hasithvm/Proxima/board/cc3200board/notes.md

Description
-----------

This document contains information about deviations from the CC3200 reference design.

Changes
-------------

1. Part Swap: Q24FA20H00396 => ABM3B-40.000MHZ-10-1-U-T

Requires changing capacitor values C42, C49 to 10pF.

http://www.adafruit.com/blog/2012/01/24/choosing-the-right-crystal-and-caps-for-your-design/
http://ww1.microchip.com/downloads/en/AppNotes/00826a.pdf
