hasithvm/Proxima/board/cc3200modboard/cc3200modboard.pdf

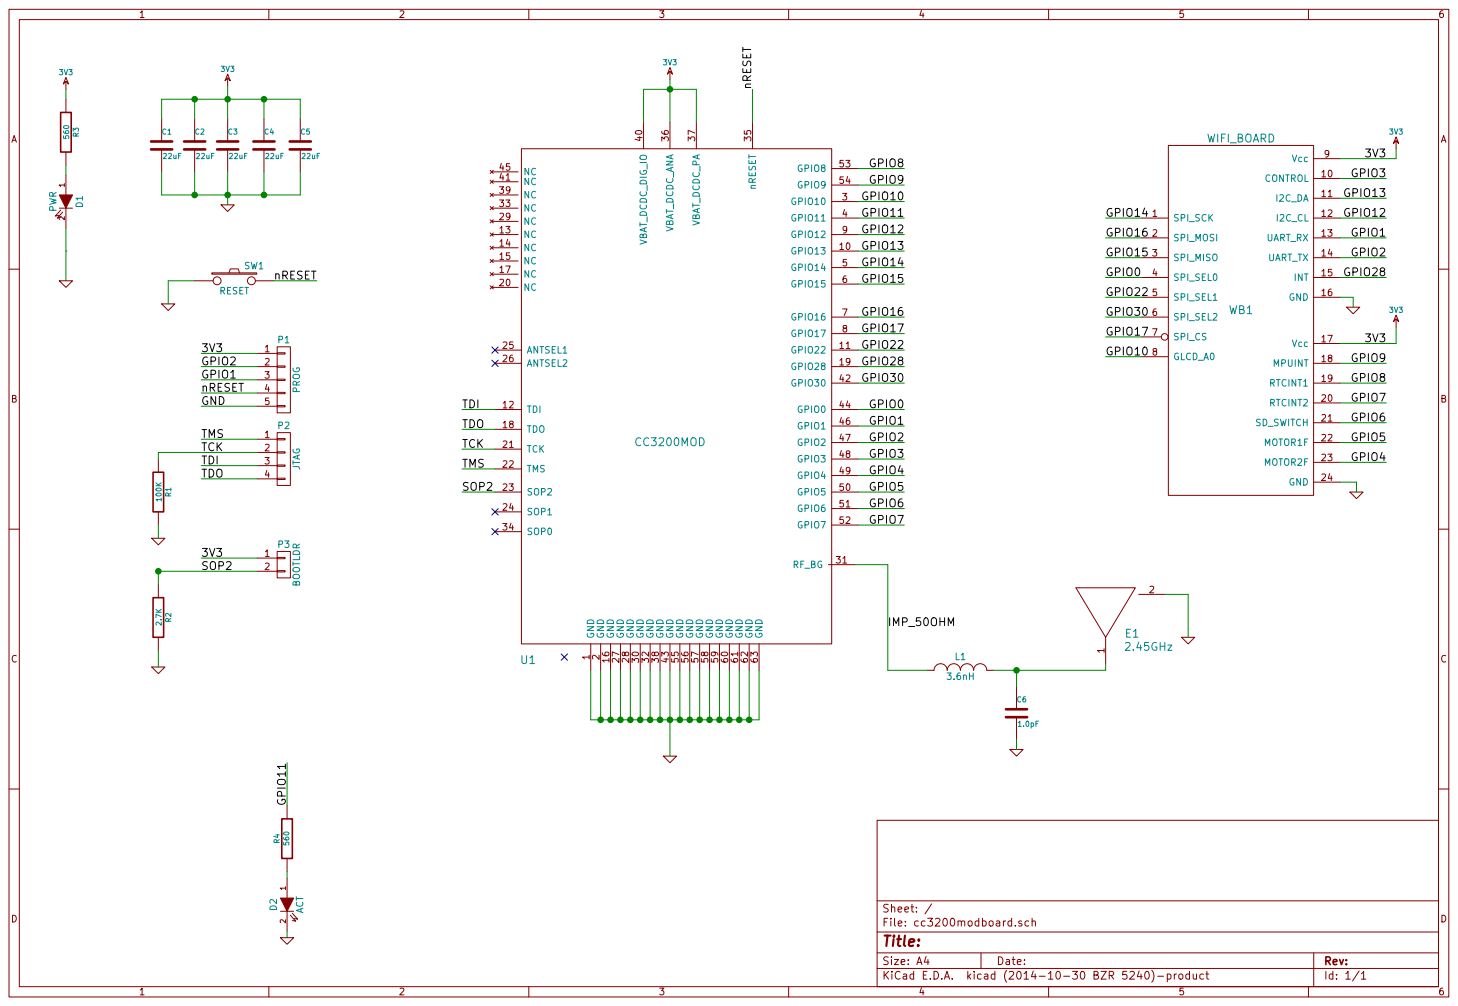
[picture p3: page 1]

2 GPIO10 3 GPIO11 4 GPIO14 5 GPIO15 6 GPIO16 7 GPIO17 8 GPIO12 9 GPIO13 10 NC 20 GND 30 VBAT_DCDC_DIG_IO 40 GPIO5 50 GND 60 GPIO22 11 TCK 21 RF_BG 31 NC 41 GPIO6 51 GND 61 TDI 12 TMS 22 GND 32 GPIO30 42 GPIO7 52 GND 62 NC 13 SOP2 23 NC 33 GND 43 GPIO8 53 GND 63 NC 14 SOP1 24 SOP0 34 GPIO0 44 GPIO9 54 NC 15 ANTSEL1 25 nRESET 35 NC 45 GND 55 GND 16 ANTSEL2 26 VBAT_DCDC_ANA 36 GPIO1 46 GND 56 NC 17 GND 27 VBAT_DCDC_PA 37 GPIO2 47 GND 57 TDO 18 GND 28 GND 38 GPIO3 48 GND 58 GPIO28 19 NC 29 NC 39 GPIO4 49 GND U1 59

TCK | 2

Id: 1/1 Title: File: cc3200modboard.sch Sheet: / GND
