hasithvm/Proxima/board/cc3200modboard/cc3200modboard.kicad_pcb

## KiCad design board/cc3200modboard/cc3200modboard.kicad_pcb (2015-07-12)

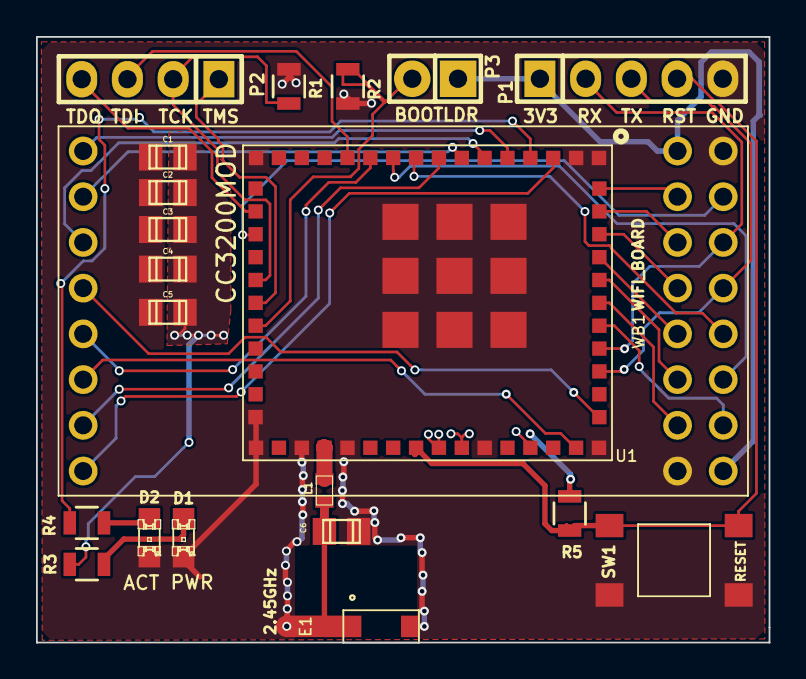
[picture p4: board cc3200modboard.kicad_pcb from above]

Board: 2 copper layers, 40.7 x 33.6 mm, 21 parts (0 on the bottom side), 33 nets.

Parts:
C1, C2, C3, C4, C5: 22uF; c_0805
C6: 1.0pF; c_0805
D1: PWR; LED-0805
D2: ACT; LED-0805
E1: 2.45GHz; 2.4GHz_ANT_AH316M245001-T
L1: 3.6nH; IND_RF_0603
P1: PROG; Pin_Header_Straight_1x05
P2: JTAG; Pin_Header_Straight_1x04
P3: BOOTLDR; Pin_Header_Straight_1x02
R1: 100K; R_0805
R2: 2.7K; R_0805
R3, R4: 560; R_0805
R5: 10K; R_0805
SW1: RESET; PTS645
U1: CC3200MOD
WB1: WIFI_BOARD; DaughterBoard

Connections:
3V3: C1.1, C2.1, C3.1, C4.1, C5.1, P1.1, P3.1, R3.1, R5.1, U1.36, U1.37, U1.40, WB1.9, WB1.17
/GPIO0: U1.44, WB1.4
/GPIO1: P1.3, U1.46, WB1.13
/GPIO2: P1.2, U1.47, WB1.14
/GPIO3: U1.48, WB1.10
/GPIO4: U1.49, WB1.23
/GPIO5: U1.50, WB1.22
/GPIO6: U1.51, WB1.21
/GPIO7: U1.52, WB1.20
/GPIO8: U1.53, WB1.19
/GPIO9: U1.54, WB1.18
/GPIO10: U1.3, WB1.8
/GPIO11: R4.1, U1.4
/GPIO12: U1.9, WB1.12
/GPIO13: U1.10, WB1.11
/GPIO14: U1.5, WB1.1
/GPIO15: U1.6, WB1.3
/GPIO16: U1.7, WB1.2
/GPIO17: U1.8, WB1.7
/GPIO22: U1.11, WB1.5
/GPIO28: U1.19, WB1.15
/GPIO30: U1.42, WB1.6
/IMP_50OHM: L1.1, U1.31
/RF_FEED: C6.1, E1.1, L1.2
/SOP2: P3.2, R2.1, U1.23
/TCK: P2.2, R1.1, U1.21
/TDI: P2.3, U1.12
/TDO: P2.4, U1.18
/TMS: P2.1, U1.22
/nRESET: P1.4, R5.2, SW1.2, U1.35
GND: C1.2, C2.2, C3.2, C4.2, C5.2, C6.2, D1.2, D2.2, E1.2, P1.5, R1.2, R2.2, SW1.1, U1.1, U1.2, U1.16, U1.27, U1.28, U1.30, U1.32, U1.38, U1.43, U1.55, U1.56, U1.57, U1.58, U1.59, U1.60, U1.61, U1.62, U1.63, WB1.16, WB1.24
unnamed: D1.1, R3.2
unnamed: D2.1, R4.2
