hasithvm/Proxima/board/cc3200board/cc3200board.kicad_pcb

## KiCad design board/cc3200board/cc3200board.kicad_pcb (2015-03-09)

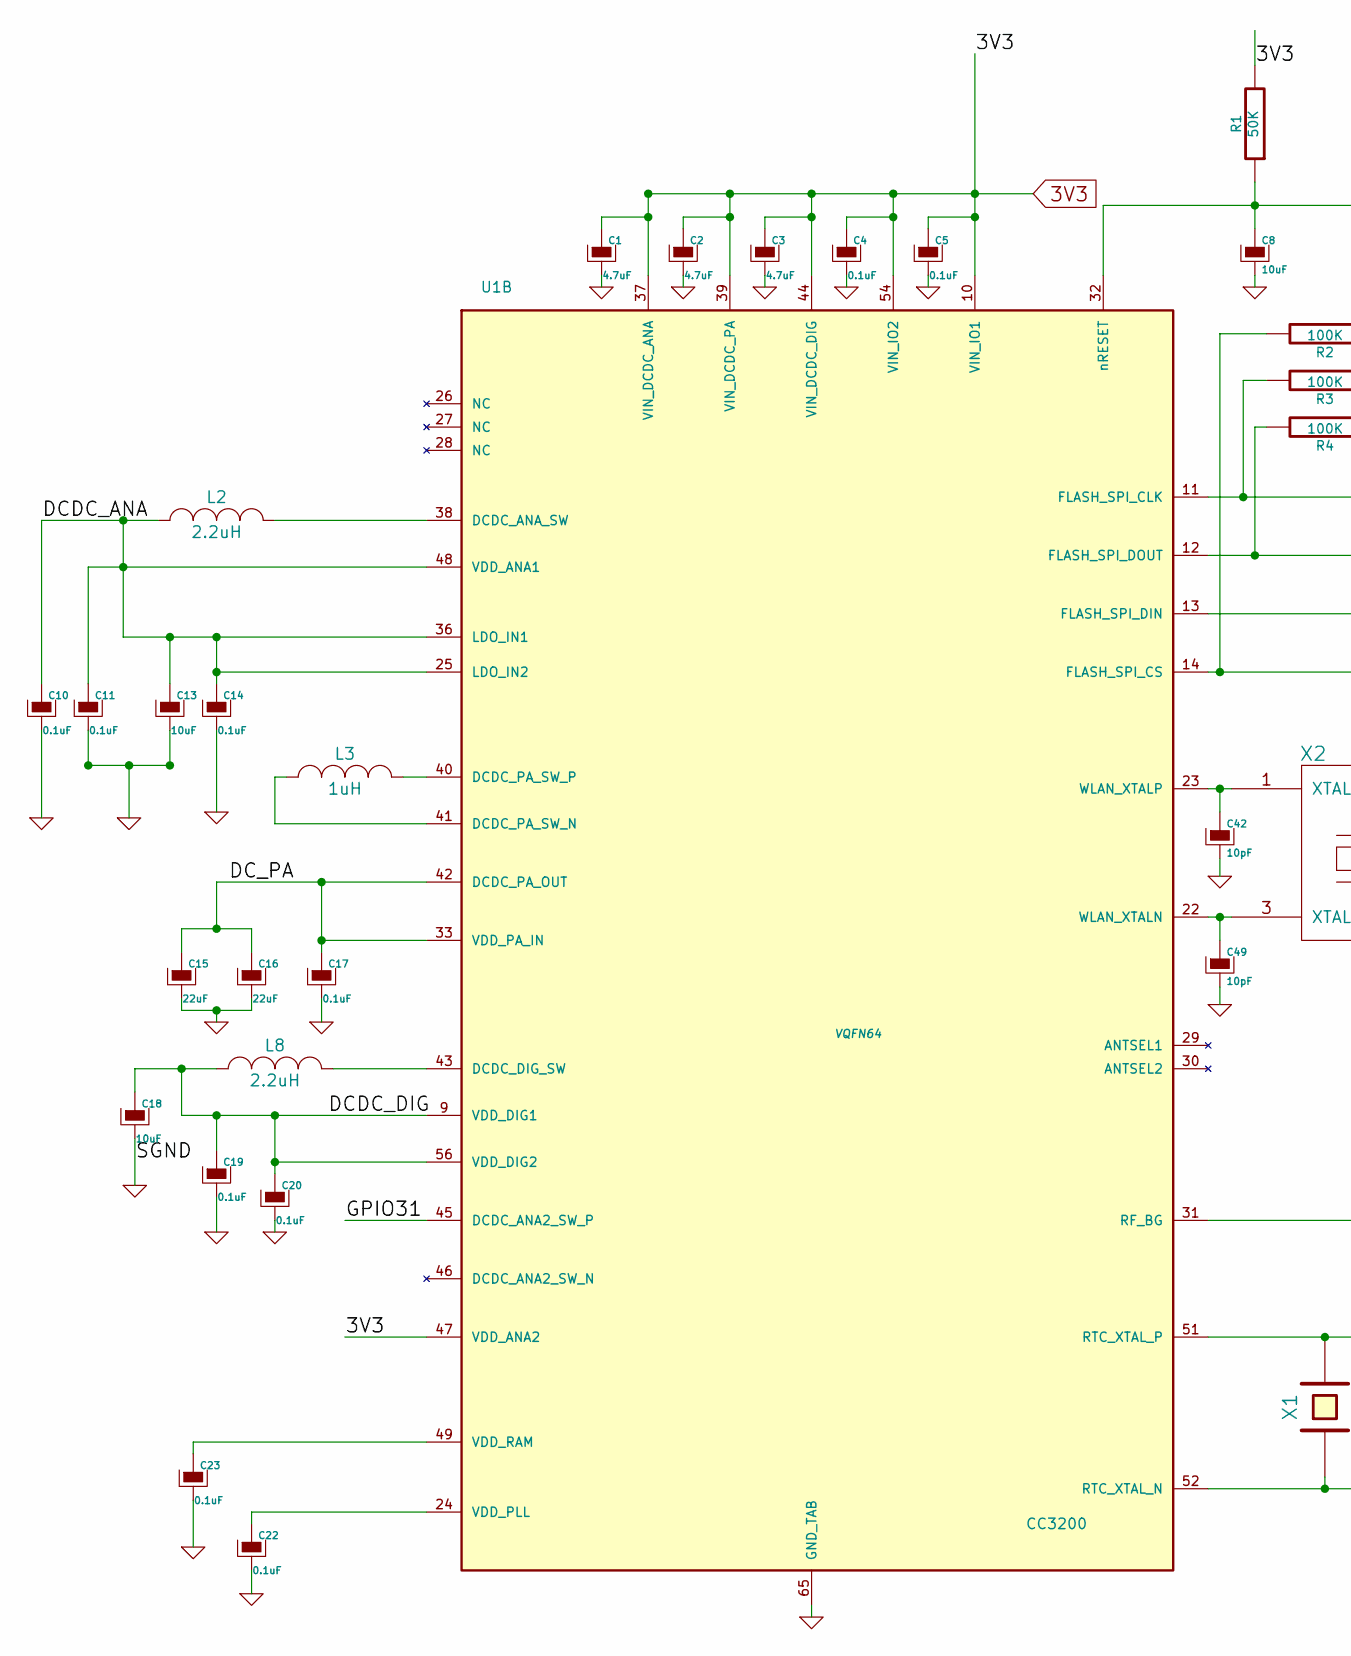
[picture p5: schematic cc3200board.sch, part in row 1, column 1]

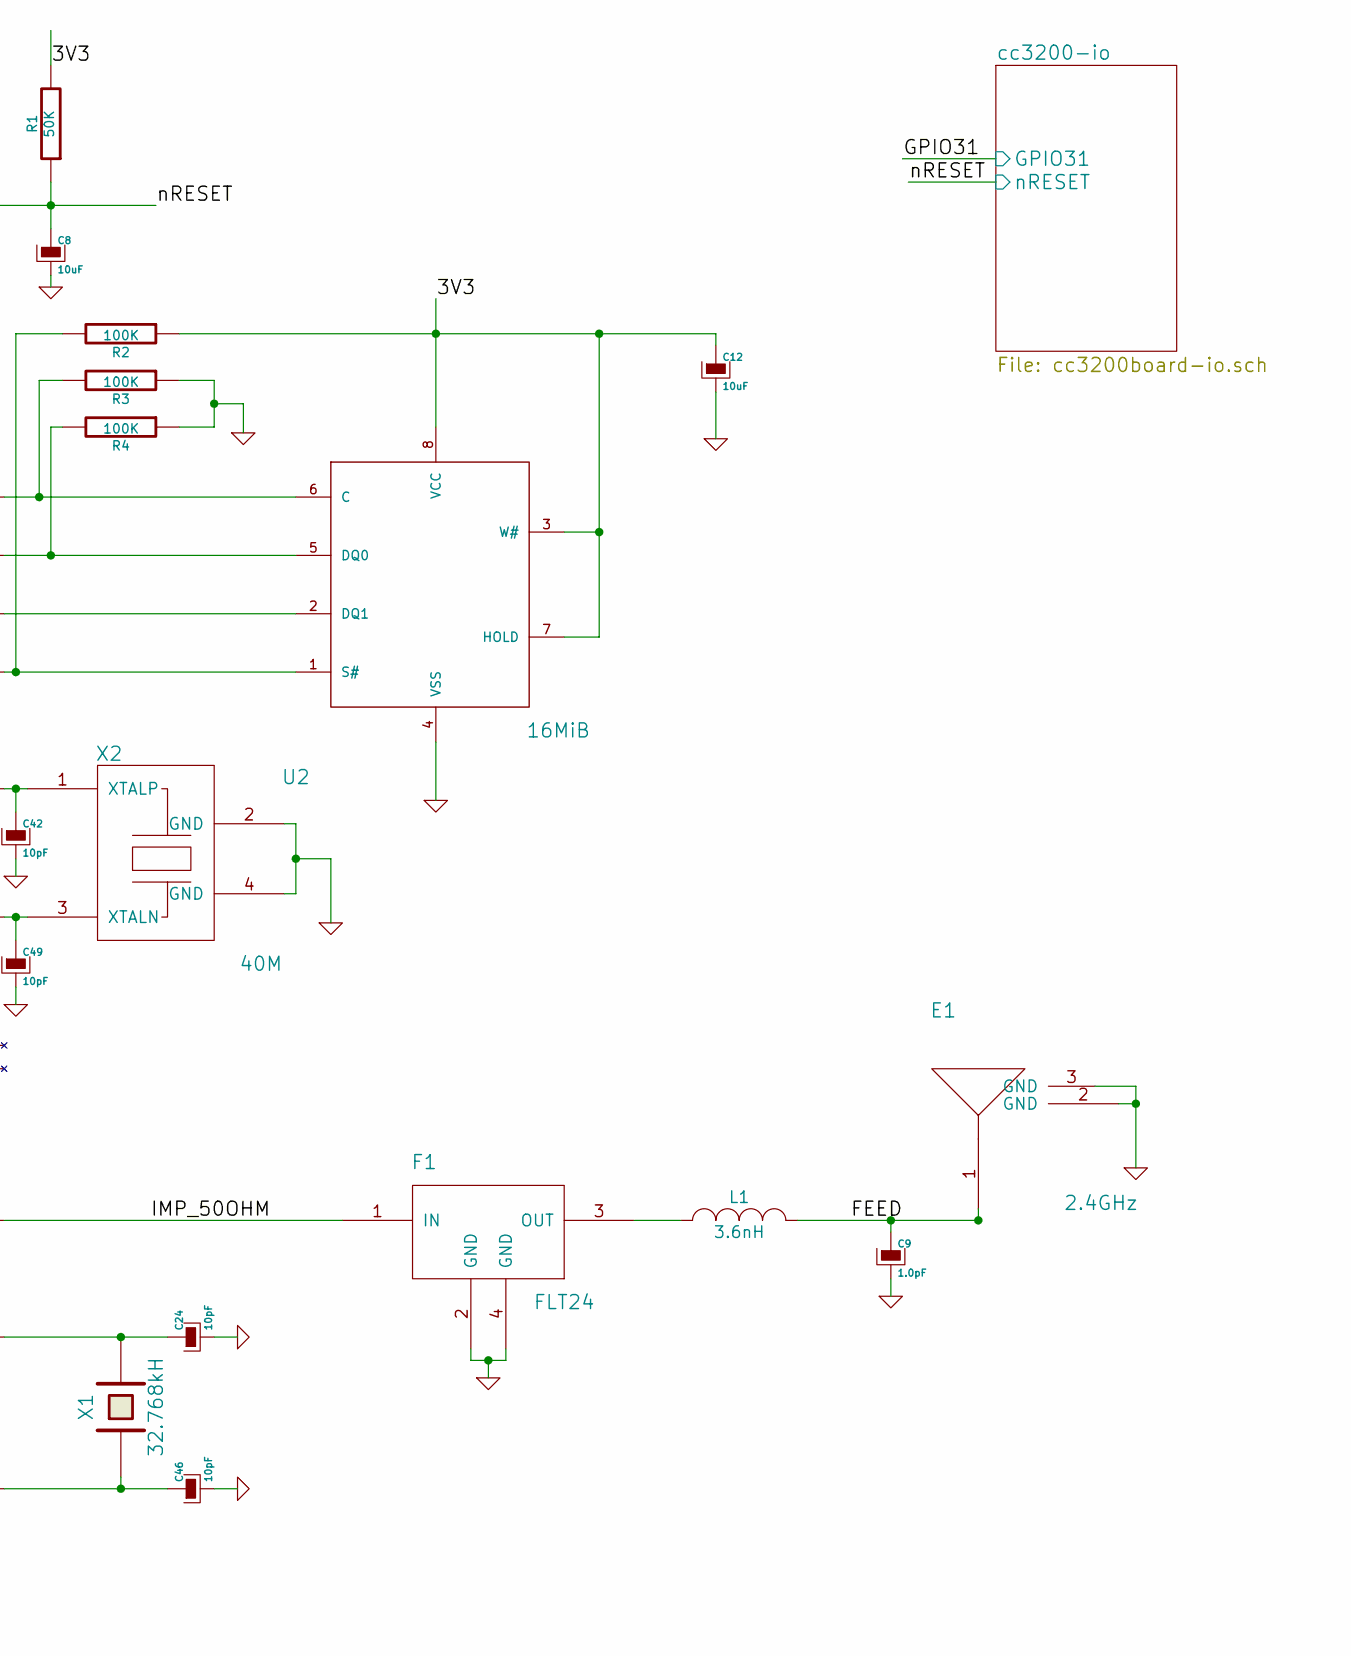
[picture p6: schematic cc3200board.sch, part in row 1, column 2]

Parts:
C1, C2, C3: 4.7uF
C4, C5, C10, C11, C14, C17, C19, C20, C22, C23: 0.1uF
C8, C12, C13, C18: 10uF
C9: 1.0pF
C15, C16: 22uF
C24, C42, C46, C49: 10pF
E1: 2.4GHz; PartNum AH316M245001-T
F1: FLT24
L1: 3.6nH
L2, L8: 2.2uH
L3: 1uH
R1: 50K
R2, R3, R4: 100K
U1: CC3200; VQFN64; PartNum CC3200R1M2RGCR
U2: 16MiB; PartNum N25Q128A13ESE40E
X1: 32.768kH
X2: 40M; PartNumber ABM3B-40.000MHZ-10-1-U-T

Connections:
3V3: C1.1, C2.1, C3.1, C4.1, C5.1, C12.1, R1.2, R2.1, U1.10 (VIN_IO1), U1.37 (VIN_DCDC_ANA), U1.39 (VIN_DCDC_PA), U1.44 (VIN_DCDC_DIG), U1.47 (VDD_ANA2), U1.54 (VIN_IO2), U2.3 (W#), U2.7 (HOLD), U2.8 (VCC); also elsewhere on the board
/DCDC_ANA: C10.1, C11.1, C13.1, C14.1, L2.1, U1.25 (LDO_IN2), U1.36 (LDO_IN1), U1.48 (VDD_ANA1)
/DCDC_DIG: C18.1, C19.1, C20.1, L8.1, U1.9 (VDD_DIG1), U1.56 (VDD_DIG2)
/DC_PA: C15.1, C16.1, C17.1, U1.33 (VDD_PA_IN), U1.42 (DCDC_PA_OUT)
/FEED: C9.1, E1.1, L1.2
/IMP_50OHM: F1.1 (IN), U1.31 (RF_BG)
/cc3200-io/GPIO31: U1.45 (DCDC_ANA2_SW_P); also elsewhere on the board
/cc3200-io/nRESET: C8.1, R1.1, U1.32 (nRESET); also elsewhere on the board
GND: C1.2, C2.2, C3.2, C4.2, C5.2, C8.2, C9.2, C10.2, C11.2, C12.2, C13.2, C14.2, C15.2, C16.2, C17.2, C18.2, C19.2, C20.2, C22.2, C23.2, C24.2, C42.2, C46.2, C49.2, E1.2 (GND), E1.3 (GND), F1.2 (GND), F1.4 (GND), R3.1, R4.1, U1.65 (GND_TAB), U2.4 (VSS), X2.2 (GND), X2.4 (GND); also elsewhere on the board
unnamed: C22.1, U1.24 (VDD_PLL)
unnamed: C23.1, U1.49 (VDD_RAM)
unnamed: C24.1, U1.51 (RTC_XTAL_P), X1.2
unnamed: C42.1, U1.23 (WLAN_XTALP), X2.1 (XTALP)
unnamed: C46.1, U1.52 (RTC_XTAL_N), X1.1
unnamed: C49.1, U1.22 (WLAN_XTALN), X2.3 (XTALN)
unnamed: F1.3 (OUT), L1.1
unnamed: L2.2, U1.38 (DCDC_ANA_SW)
unnamed: L3.1, U1.41 (DCDC_PA_SW_N)
unnamed: L3.2, U1.40 (DCDC_PA_SW_P)
unnamed: L8.2, U1.43 (DCDC_DIG_SW)
unnamed: R2.2, U1.14 (FLASH_SPI_CS), U2.1 (S#)
unnamed: R3.2, U1.11 (FLASH_SPI_CLK), U2.6 (C)
unnamed: R4.2, U1.12 (FLASH_SPI_DOUT), U2.5 (DQ0)
unnamed: U1.13 (FLASH_SPI_DIN), U2.2 (DQ1)

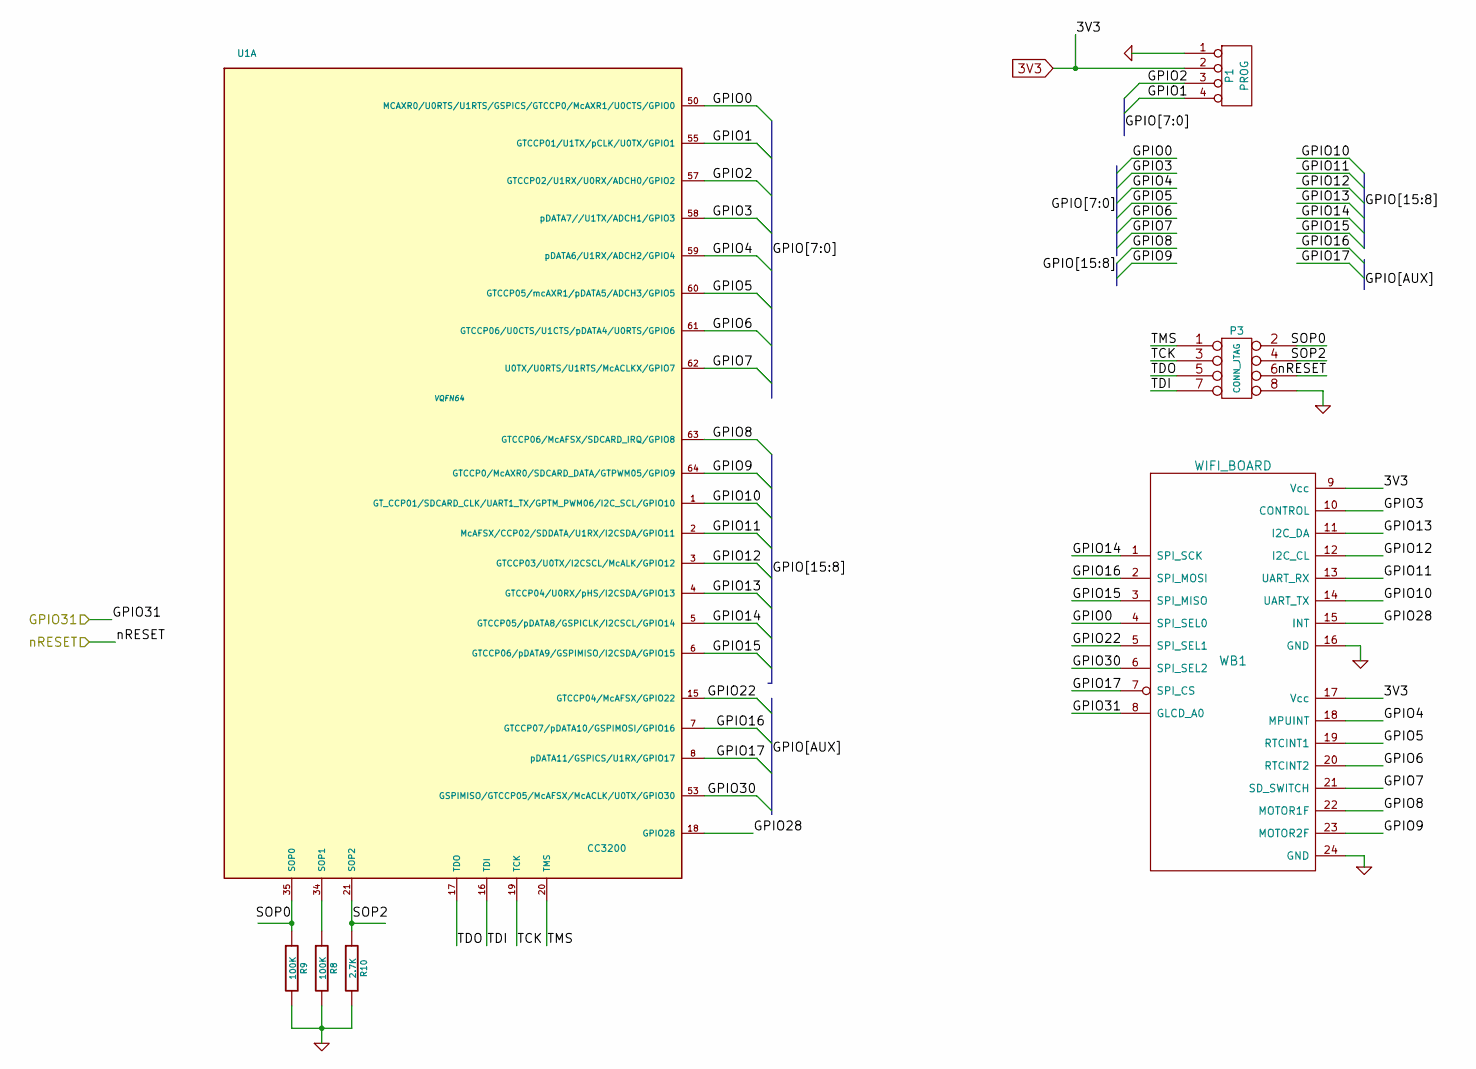
[picture p7: schematic cc3200board-io.sch]

Parts:
P1: PROG
P3: CONN_JTAG
R8, R9: 100K
R10: 2.7K
U1: CC3200; VQFN64
WB1: WIFI_BOARD

Connections:
3V3: P1.2, WB1.9 (Vcc), WB1.17 (Vcc); also elsewhere on the board
/cc3200-io/GPIO0: U1.50 (MCAXR0/U0RTS/U1RTS/GSPICS/GTCCP0/McAXR1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), WB1.4 (SPI_SEL0)
/cc3200-io/GPIO1: P1.4, U1.55 (GTCCP01/U1TX/pCLK/U0TX/GPIO1)
/cc3200-io/GPIO2: P1.3, U1.57 (GTCCP02/U1RX/U0RX/ADCH0/GPIO2)
/cc3200-io/GPIO3: U1.58 (pDATA7//U1TX/ADCH1/GPIO3), WB1.10 (CONTROL)
/cc3200-io/GPIO4: U1.59 (pDATA6/U1RX/ADCH2/GPIO4), WB1.18 (MPUINT)
/cc3200-io/GPIO5: U1.60 (GTCCP05/mcAXR1/pDATA5/ADCH3/GPIO5), WB1.19 (RTCINT1)
/cc3200-io/GPIO6: U1.61 (GTCCP06/U0CTS/U1CTS/pDATA4/U0RTS/GPIO6), WB1.20 (RTCINT2)
/cc3200-io/GPIO7: U1.62 (U0TX/U0RTS/U1RTS/McACLKX/GPIO7), WB1.21 (SD_SWITCH)
/cc3200-io/GPIO8: U1.63 (GTCCP06/McAFSX/SDCARD_IRQ/GPIO8), WB1.22 (MOTOR1F)
/cc3200-io/GPIO9: U1.64 (GTCCP0/McAXR0/SDCARD_DATA/GTPWM05/GPIO9), WB1.23 (MOTOR2F)
/cc3200-io/GPIO10: U1.1 (GT_CCP01/SDCARD_CLK/UART1_TX/GPTM_PWM06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), WB1.14 (UART_TX)
/cc3200-io/GPIO11: U1.2 (McAFSX/CCP02/SDDATA/U1RX/I2CSDA/GPIO11), WB1.13 (UART_RX)
/cc3200-io/GPIO12: U1.3 (GTCCP03/U0TX/I2CSCL/McALK/GPIO12), WB1.12 (I2C_CL)
/cc3200-io/GPIO13: U1.4 (GTCCP04/U0RX/pHS/I2CSDA/GPIO13), WB1.11 (I2C_DA)
/cc3200-io/GPIO14: U1.5 (GTCCP05/pDATA8/GSPICLK/I2CSCL/GPIO14), WB1.1 (SPI_SCK)
/cc3200-io/GPIO15: U1.6 (GTCCP06/pDATA9/GSPIMISO/I2CSDA/GPIO15), WB1.3 (SPI_MISO)
/cc3200-io/GPIO16: U1.7 (GTCCP07/pDATA10/GSPIMOSI/GPIO16), WB1.2 (SPI_MOSI)
/cc3200-io/GPIO17: U1.8 (pDATA11/GSPICS/U1RX/GPIO17), WB1.7 (SPI_CS)
/cc3200-io/GPIO22: U1.15 (GTCCP04/McAFSX/GPIO22), WB1.5 (SPI_SEL1)
/cc3200-io/GPIO28: U1.18 (GPIO28), WB1.15 (INT)
/cc3200-io/GPIO30: U1.53 (GSPIMISO/GTCCP05/McAFSX/McACLK/U0TX/GPI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), WB1.6 (SPI_SEL2)
/cc3200-io/GPIO31: WB1.8 (GLCD_A0); also elsewhere on the board
/cc3200-io/SOP0: P3.2, R9.1, U1.35 (SOP0)
/cc3200-io/SOP2: P3.4, R10.1, U1.21 (SOP2)
/cc3200-io/TCK: P3.3, U1.19 (TCK)
/cc3200-io/TDI: P3.7, U1.16 (TDI)
/cc3200-io/TDO: P3.5, U1.17 (TDO)
/cc3200-io/TMS: P3.1, U1.20 (TMS)
/cc3200-io/nRESET: P3.6; also elsewhere on the board
GND: P1.1, P3.8, R8.2, R9.2, R10.2, WB1.16 (GND), WB1.24 (GND); also elsewhere on the board
unnamed: R8.1, U1.34 (SOP1)

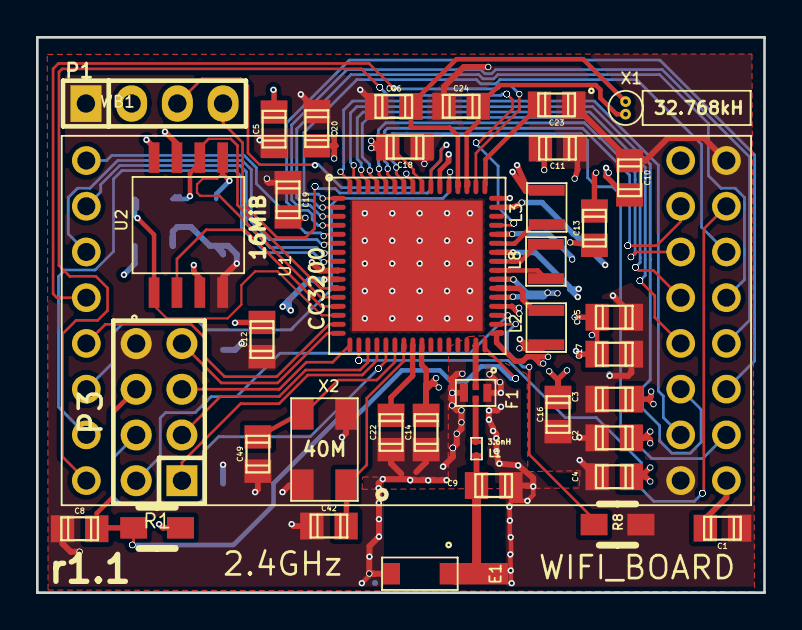
[picture p8: board cc3200board.kicad_pcb from above]

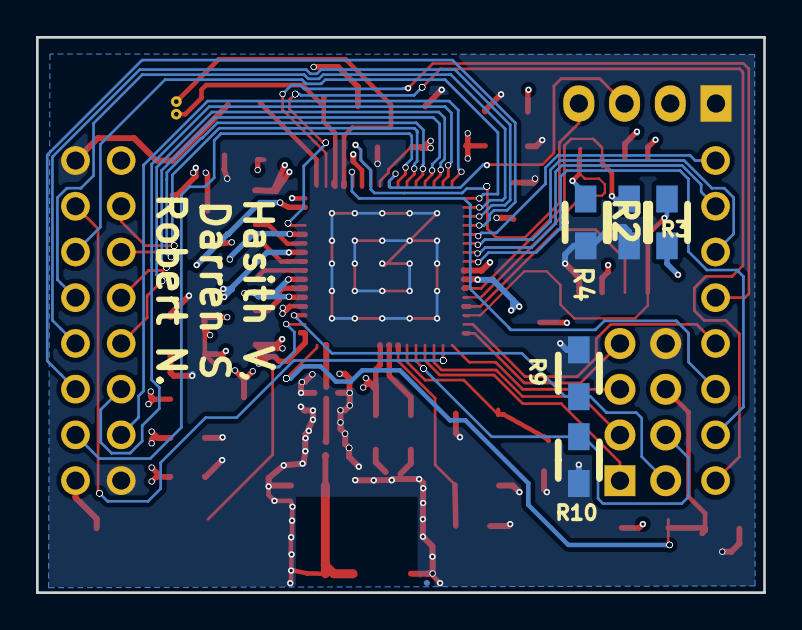
[picture p9: board cc3200board.kicad_pcb from below]

Board: 4 copper layers, 40.4 x 30.8 mm, 44 parts (5 on the bottom side), 52 nets.
