hasithvm/Proxima/board/mainboard/mainboard.kicad_pcb

## KiCad design board/mainboard/mainboard.kicad_pcb (2015-03-03)

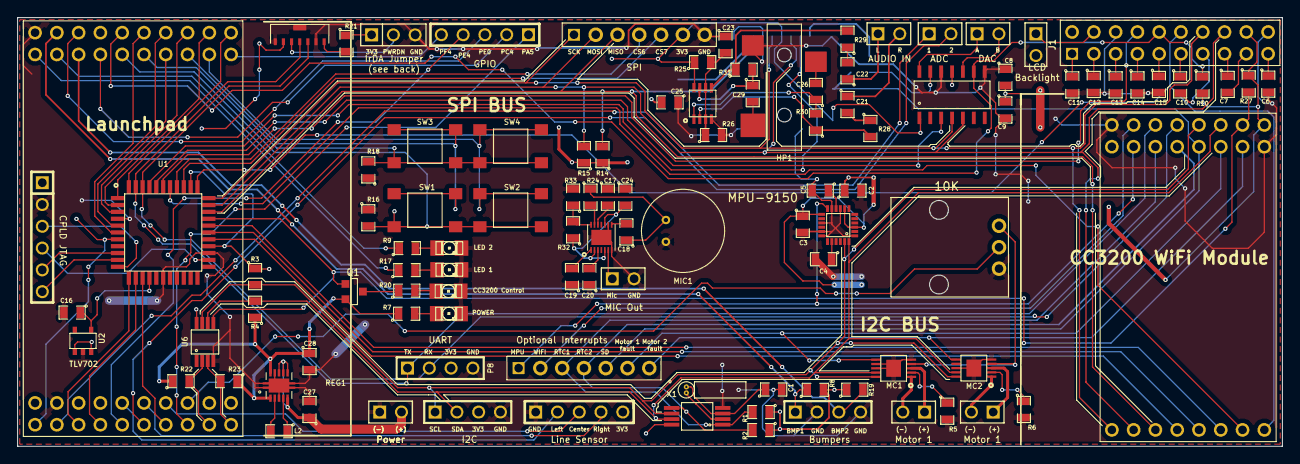
[picture p10: board mainboard.kicad_pcb from above]

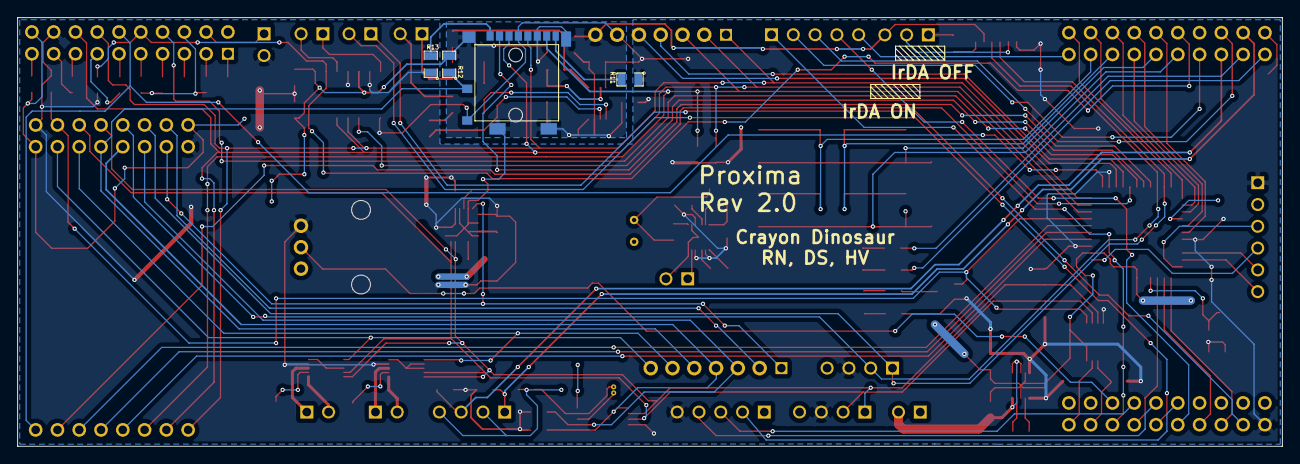
[picture p11: board mainboard.kicad_pcb from below]

Board: 2 copper layers, 147.5 x 50.0 mm, 109 parts (4 on the bottom side), 117 nets.

Parts:
AUD1: LM4808
C1: 5pF; SM0805
C2, C5, C8, C24: 0.1uF; SM0805
C3: 10nF; SM0805
C4: 2.2nF; SM0805
C6, C7, C10, C11, C12, C13, C14, C15, C16, C25: 1uF; SM0805
C9, C27, C28: 10uF; SM0805
C17: 470nF; SM0805
C18, C19: 680nF; SM0805
C20, C21, C22: 2.2uF; SM0805
C23: 1.0uF; SM0805
C26, C29: 100uF; SM0805
D1: GLED; LED-1206
D2: RLED; LED-1206
D3: POWER; LED-1206
D4: CONTROL; LED-1206
DAC1: MCP4902
GLCD1: NHD-C12832A1Z-NSW-BBW-3V3; 2x10_Headers
HP1: HP_JACK; HeadphoneJack
IR1: RPM841-H11; RPM973-H11
J1: BACKL; PIN_ARRAY_2X1
K1: IRDA_EN; PIN_ARRAY_3X1
L2: 2.2uH; SM0805
LP1: TIVALAUNCHPAD; TivaC
MC1, MC2: DRV8830; DRV8830MSOP
MIC1: CMA-4544PF-W; CMA-4544
MPU1: MPU-9150; MPU9150
P1: I2C; PIN_ARRAY_4x1
P2: Motor1; PIN_ARRAY_2X1
P3: Motor2; PIN_ARRAY_2X1
P4: SPI; 1x7_Headers
P5: DAC; PIN_ARRAY_2X1
P6: CONN_5; PIN_ARRAY_5x1
P7: ANALOG; PIN_ARRAY_2X1
P8: OPTIONAL_PERIPH; 1x7_Headers
P9: GPIO; PIN_ARRAY_5x1
P10: BUMPERS; PIN_ARRAY_4x1
P11: CPLD_JTAG; PIN_ARRAY-6X1
P12: POWER; PIN_ARRAY_2X1
P13: UART; PIN_ARRAY_4x1
P14: AUDIO; PIN_ARRAY_2X1
P15: MIC; PIN_ARRAY_2X1
Q1: BSS84; SOT23GDS
R1, R2, R16, R18, R27: 10K; SM0805
R3, R4, R22, R23: 4.7k; SM0805
R5, R6: 0.2; SM0805
R7, R9, R17, R20: 220; SM0805
R8, R11, R13, R14, R15, R19: 47k; SM0805
R10, R12: 10k; SM0805
R21: 3; SM0805
R24: 2.2k; SM0805
R25, R26: 100k; SM0805
R28, R29, R30, R31: 3.9k; SM0805
R32, R33: 150k; SM0805
REG1: TPS63001
RTC1: S-35390A; S35390A
RV1: 10K; P090_Potentiometer
SD1: SDCARD_PUSH; SDCARD_Push
SW1, SW2, SW3, SW4: SW_PUSH; PTS645
U1: XC2C32A; CoolrunnerII
U2: TLV702; SOT23-5
U3: MAX9814
U6: PCA9515B
WB1: WIFI_BOARD; DaughterBoard
X1: 32.768KHz; XTAL-32K

Connections:
3V3: AUD1.8, C2.1, C3.1, C8.2, C9.1, C24.2, C25.2, C28.1, DAC1.1, DAC1.11, DAC1.13, GLCD1.12, IR1.6, J1.2, K1.1, LP1.1, MC1.4, MC2.4, MPU1.3, MPU1.8, MPU1.13, P1.3, P4.6, P6.5, P11.1, P13.3, Q1.S, R1.1, R2.1, R3.1, R4.1, R7.1, R8.2, R10.2, R11.1, R13.1, R14.1, R15.1, R19.1, R21.1, R22.1, R23.1, R25.1, R27.1, R32.1, REG1.1, REG1.10, RTC1.8, RV1.3, SD1.4, SD1.9, U1.7, U1.26, U1.35, U2.1, U2.3, U3.2, U3.5, U3.10, U6.8, WB1.9, WB1.17
+1.8V: C16.1, U1.15, U2.4
AIN1: LP1.2, P7.1
AIN2: LP1.6, P7.2
BUMP1: LP1.19, P10.1, R8.1
BUMP2: LP1.38, P10.3, R19.2
CC_CONTROL: Q1.G, R27.2, U1.30, U6.5, WB1.10
CPLD_TCK: P11.3, U1.11
CPLD_TDI: P11.5, U1.9
CPLD_TDO: P11.4, U1.24
CPLD_TMS: P11.6, U1.10
GLCD_A0: GLCD1.15, U1.34, WB1.8
GLCD_A0_LP: LP1.34, U1.3
GND: AUD1.4, C1.2, C2.2, C3.2, C4.2, C5.2, C6.2, C8.1, C9.2, C11.2, C12.2, C13.2, C14.2, C15.2, C16.2, C17.1, C19.1, C20.1, C23.1, C24.1, C25.1, C27.2, C28.2, D1.2, D2.2, D3.2, D4.2, DAC1.8, DAC1.12, GLCD1.11, GLCD1.18, HP1.5, IR1.2, IR1.7, K1.3, LP1.20, LP1.22, MC1.5, MC1.7, MC1.8, MC2.5, MC2.8, MIC1.2, MPU1.1, MPU1.9, MPU1.11, MPU1.15, MPU1.17, MPU1.18, P1.4, P4.7, P6.1, P10.2, P10.4, P11.2, P12.1, P13.4, P15.2, R5.2, R6.2, R12.2, R16.1, R18.1, R26.2, R33.2, REG1.3, REG1.9, RTC1.4, RV1.1, SD1.6, U1.4, U1.17, U1.25, U2.2, U3.7, U3.9, U6.4, WB1.16, WB1.24
I2C_CL: MC1.10, MC2.10, MPU1.23, P1.1, R3.2, RTC1.6, U6.7, WB1.12
I2C_CL_LP: LP1.9, R22.2, U6.2
I2C_DA: MC1.9, MC2.9, MPU1.24, P1.2, R4.2, RTC1.7, U6.6, WB1.11
I2C_DA_LP: LP1.10, R23.2, U6.3
KPAD_C1: LP1.36, R16.2, SW1.2, SW2.2
KPAD_C2: LP1.35, R18.2, SW3.2, SW4.2
KPAD_R1: LP1.33, SW1.1, SW3.1
KPAD_R2: LP1.32, SW2.1, SW4.1
LED1: LP1.40, R17.1
LED2: LP1.39, R9.1
LINE_SENSOR_C: LP1.27, P6.3
LINE_SENSOR_L: LP1.25, P6.2
LINE_SENSOR_R: LP1.26, P6.4
MOTOR1+: MC1.3, P2.1
MOTOR1-: MC1.1, P2.2
MOTOR1F: MC1.6, P8.6, WB1.22
MOTOR2+: MC2.3, P3.1
MOTOR2-: MC2.1, P3.2
MOTOR2F: MC2.6, P8.7, WB1.23
MPUINT: MPU1.12, P8.1, WB1.18
unnamed: MC2.2, R6.1
unnamed: C5.1, MPU1.10
unnamed: C4.1, MPU1.20
unnamed: MC1.2, R5.1
unnamed: C1.1, RTC1.3, X1.1
unnamed: RTC1.2, X1.2
unnamed: DAC1.10, P5.2
unnamed: DAC1.14, P5.1
unnamed: R13.2, SD1.1
unnamed: C15.1, GLCD1.5
unnamed: C14.1, GLCD1.4
unnamed: C13.1, GLCD1.3
unnamed: C12.1, GLCD1.2
unnamed: C6.1, GLCD1.10
unnamed: C11.1, GLCD1.1
unnamed: R11.2, SD1.8
unnamed: GLCD1.19, J1.1
unnamed: C10.1, GLCD1.6
unnamed: C7.1, GLCD1.8
unnamed: C7.2, GLCD1.9
unnamed: C10.2, GLCD1.7
unnamed: D2.1, R17.2
unnamed: IR1.5, K1.2
unnamed: IR1.1, R21.2
unnamed: Q1.D, R20.1
unnamed: D3.1, R7.2
unnamed: D1.1, R9.2
unnamed: D4.1, R20.2
unnamed: L2.2, REG1.2
unnamed: L2.1, REG1.4
unnamed: C27.1, P12.2, REG1.5, REG1.6, REG1.7, REG1.8
unnamed: AUD1.7, C29.1, R31.2
unnamed: C22.2, R29.1
unnamed: AUD1.3, AUD1.6, C23.2, R25.2, R26.1
unnamed: AUD1.5, R29.2, R31.1
unnamed: AUD1.2, R28.2, R30.1
unnamed: C29.2, HP1.4
unnamed: C26.2, HP1.1
unnamed: C22.1, P14.1
unnamed: C21.1, P14.2
unnamed: C17.2, U3.12
unnamed: R32.2, R33.1, U3.14
unnamed: P15.1, U3.6
unnamed: AUD1.1, C26.1, R30.2
unnamed: C21.2, R28.1
unnamed: C20.2, U3.3
unnamed: R24.2, U3.13
unnamed: C18.1, MIC1.1, R24.1
unnamed: C18.2, U3.8
unnamed: C19.2, U3.1
PA5: LP1.8, P9.1
PC4: LP1.37, P9.2
PE0: LP1.18, P9.3
PE4: LP1.5, P9.4
PF4: LP1.31, P9.5
POT: LP1.28, RV1.2
RST: DAC1.9, GLCD1.16, LP1.16, R10.1
RTCINT1: P8.3, R1.2, RTC1.1, WB1.19
RTCINT2: P8.4, R2.2, RTC1.5, WB1.20
SD_SWITCH: P8.5, R12.1, SD1.10, WB1.21
SPI_CS1: SD1.2, U1.41
SPI_CS2: DAC1.3, U1.40
SPI_CS3: GLCD1.17, U1.39
SPI_CS5: U1.38, WB1.7
SPI_CS6: P4.4, U1.37
SPI_CS7: P4.5, U1.36
SPI_MISO: P4.3, R14.2, SD1.7, U1.31, WB1.3
SPI_MISO_LP: LP1.14, U1.5
SPI_MOSI: DAC1.5, GLCD1.13, P4.2, R15.2, SD1.3, U1.32, WB1.2
SPI_MOSI_LP: LP1.15, U1.6
SPI_SCK: DAC1.4, GLCD1.14, P4.1, SD1.5, U1.33, WB1.1
SPI_SCK_LP: LP1.7, U1.14
SPI_SEL0_CC: U1.27, WB1.4
SPI_SEL0_LP: LP1.11, U1.44
SPI_SEL1_CC: U1.28, WB1.5
SPI_SEL1_LP: LP1.12, U1.1
SPI_SEL2_CC: U1.29, WB1.6
SPI_SEL2_LP: LP1.13, U1.2
UART_RX: IR1.3, P13.2, U1.42, WB1.13
UART_RX_LP: LP1.3, U1.12
UART_TX: IR1.4, P13.1, U1.43, WB1.14
UART_TX_LP: LP1.4, U1.13
WIFI_INT: P8.2, WB1.15
