hasithvm/Proxima/board/sensorarray/sensorarray.kicad_pcb

## KiCad design board/sensorarray/sensorarray.kicad_pcb (2014-12-02)

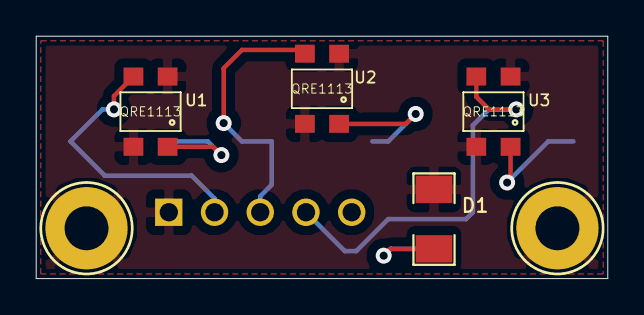
[picture p12: board sensorarray.kicad_pcb from above]

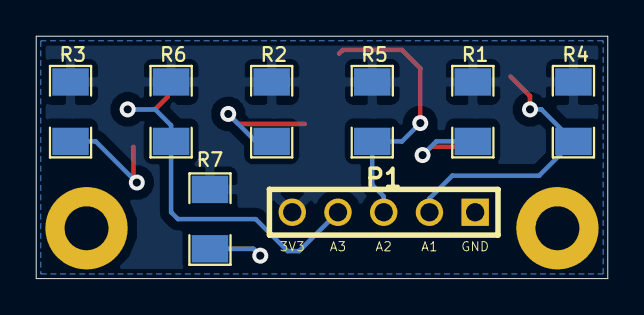
[picture p13: board sensorarray.kicad_pcb from below]

Board: 2 copper layers, 31.8 x 13.5 mm, 14 parts (8 on the bottom side), 9 nets.

Parts:
D1: DIODE; SM1206
P1: CONN_5; PIN_ARRAY_5x1
P2, P3: CONN_1; 2-48_mount
R1, R2, R3: 56; SM1206
R4, R5, R6: 8.2k; SM1206
R7: 10k; SM1206
U1, U2, U3: QRE1113

Connections:
3V3: P1.5, R1.1, R2.1, R3.1, R4.1, R5.1, R6.1, R7.1
A1: P1.2, R4.2, U1.3
A2: P1.3, R5.2, U2.3
A3: P1.4, R6.2, U3.3
GND: D1.1, P1.1, P2.1, P3.1, U1.2, U1.4, U2.2, U2.4, U3.2, U3.4
unnamed: R3.2, U3.1
unnamed: D1.2, R7.2
unnamed: R2.2, U2.1
unnamed: R1.2, U1.1
