hasithvm/Proxima/cc3200/bootloader/src/main.c

//*****************************************************************************
// main.c
//
//*****************************************************************************

#include <stdint.h>

#include "simplelink.h"

#include "rom.h"
#include "rom_map.h"

#include "hw_types.h"
#include "hw_gpio.h"
#include "hw_ints.h"
#include "hw_memmap.h"
#include "hw_nvic.h"

#include "gpio.h"
#include "interrupt.h"
#include "pin.h"
#include "prcm.h"
#include "uart.h"

#include "file.h"
#include "gpio_if.h"
#include "uart_if.h"

#define UNUSED(a) (void)(a)

extern void (* const g_pfnVectors[])(void);

extern uint8_t _text;
extern uint8_t _newvector;
extern uint8_t __vector_start;
extern uint8_t __vector_end;
extern uint8_t __bootload_sram_start;
extern uint8_t __bootload_text_start;
extern uint8_t __bootload_text_end;

/****************************************************************************/
/*                      LOCAL FUNCTION PROTOTYPES                           */
/****************************************************************************/
static void BoardInit(void);

/****************************************************************************/
/*                      LOCAL FUNCTION DEFINITIONS                          */
/****************************************************************************/

//*****************************************************************************
//
//! Board Initialization & Configuration
//!
//! \param  None
//!
//! \return None
//
//*****************************************************************************
static void
BoardInit(void)
{
    //MAP_IntVTableBaseSet((unsigned long)&g_pfnVectors[0]);

    PRCMCC3200MCUInit();

    //
    // Enable LED Peripheral
    //
    MAP_PRCMPeripheralClkEnable(PRCM_GPIOA1, PRCM_RUN_MODE_CLK);

    //
    // Setup LEDs
    //
    MAP_PinTypeGPIO(PIN_01, PIN_MODE_0, false);
    MAP_PinTypeGPIO(PIN_02, PIN_MODE_0, false);
    MAP_PinTypeGPIO(PIN_64, PIN_MODE_0, false);

    // Setup SW3
    MAP_PinTypeGPIO(PIN_04, PIN_MODE_0, false);

    MAP_GPIODirModeSet(GPIOA1_BASE, 0x20, GPIO_DIR_MODE_IN);
    MAP_GPIODirModeSet(GPIOA1_BASE, 0x2, GPIO_DIR_MODE_OUT); // GPIO9 = A1 bit 0x02
    MAP_GPIODirModeSet(GPIOA1_BASE, 0x4, GPIO_DIR_MODE_OUT);
    MAP_GPIODirModeSet(GPIOA1_BASE, 0x8, GPIO_DIR_MODE_OUT);
}

//****************************************************************************
//
//! Main function
//!
//! \param none
//!
//! This function
//!    1. Invokes the LEDBlinkyTask
//!
//! \return None.
//
//****************************************************************************

void BootloaderMain();

__attribute__ ((section (".inittext")))
int
main()
{
    // Copy the main bootloader into place at the end of RAM
    uint8_t* dst = &_newvector;
    uint8_t* src = &__vector_start;

    // Copy the vector table
    while(src < &__vector_end) {
        *dst++ = *src++;
    }
    // Update the nvic
    HWREG(NVIC_VTABLE) = (uint32_t)&_newvector;

    // Copy the program code
    src = &__bootload_text_start;
    while(src < &__bootload_text_end) {
        *dst++ = *src++;
    }

    BootloaderMain();

    return 0;
}

void BootloadFile() {
    GPIO_IF_LedOn(MCU_RED_LED_GPIO);
    GPIO_IF_LedOn(MCU_ORANGE_LED_GPIO);

    if (LoadFile((uint8_t*)"/usr/appimg.bin", &__bootload_sram_start)) {
        UartWrite("Successfully loaded user application.\n");

    } else {
        UartWrite("Failed to load user application.\n");
    }

    HWREG(NVIC_VTABLE) = (uint32_t)&__bootload_sram_start;
    uint32_t addr = (uint32_t)&__bootload_sram_start;

    __asm("ldr r1, [%0]\n"
          "mov sp, r1" :: "r"(addr) :);

    addr += 4;

    __asm("ldr r0, [%0]\n"
          "bx  r0" :: "r"(addr) :);
    while(1);
}

void BootloaderMain() {
    //
    // Initialize Board configurations
    //
    BoardInit();

    GPIO_IF_LedConfigure(LED1|LED2|LED3);

	GPIO_IF_LedOff(MCU_ALL_LED_IND);
    GPIO_IF_LedOn(MCU_ORANGE_LED_GPIO);

    sl_Start(NULL, NULL, NULL);
    EnableUart();

    GPIO_IF_LedOff(MCU_ORANGE_LED_GPIO);
    //
    // Power on the corresponding GPIO port B for 9,10,11.
    // Set up the GPIO lines to mode 0 (GPIO)
    //

    if (!(HWREG(GPIOA1_BASE + GPIO_O_GPIO_DATA + 0x80) & 0x20)) {
        BootloadFile();
    }

    while(1) {
        GPIO_IF_LedOn(MCU_GREEN_LED_GPIO);
        GPIO_IF_LedOff(MCU_RED_LED_GPIO);

        long choice = UartReadChar();

        GPIO_IF_LedOff(MCU_GREEN_LED_GPIO);
        GPIO_IF_LedOn(MCU_RED_LED_GPIO);

        if (choice == 'w') {
            UartWrite("write OK\n");
            WriteFile();
        } else if (choice == 'r') {
            UartWrite("read OK\n");
            ReadFile();
        } else if (choice == 'd') {
            UartWrite("delete OK\n");
            DeleteFile();
        } else if (choice == 'i') {
            UartWrite("info OK\n");
            InfoFile();
        } else if (choice == 'q') {
            UartWrite("quit OK\n");
            BootloadFile();
        } else {
            UartWrite("Unknown Command\n");
        }
    }
}

void SimpleLinkWlanEventHandler(SlWlanEvent_t *s) {
    UNUSED(s);
}
void SimpleLinkSockEventHandler(SlSockEvent_t *s) {
    UNUSED(s);
}
void SimpleLinkNetAppEventHandler(SlNetAppEvent_t *s) {
    UNUSED(s);
}
void SimpleLinkHttpServerCallback(SlHttpServerEvent_t *event, SlHttpServerResponse_t *resp) {
    UNUSED(event);
    UNUSED(resp);
}
