hasithvm/Proxima/cc3200/bootloader/tools/del.py

#!/usr/bin/env python
import serial
import sys

ser = serial.Serial('/dev/cc1', 921600)
ser.flushInput();
ser.setTimeout(2)
print "Waiting for response"
ser.write("d")
delConf = ser.readline()
if delConf == "":
    print "No response, please ensure the device is in bootloader mode."
    exit()
elif delConf != "delete OK\n":
    print "Error establishing delete"
    exit()

print "Please enter the filename to delete: "
fname = raw_input()
ser.write(fname + "\n")

print "Waiting for confirmation"
resp = ser.readline()
if resp == "DONE\n":
    print "File deleted"
else:
    print "Error encountered:", resp

ser.close()
