hasithvm/Proxima/(commit log)

2014-09-29 Fixed argument parsing for 2 args
    [write.py]
2014-09-29 OFLAGS will disable debug and insert optimizations
2014-09-29 Added gdb init script and openocd config script
    [cc3200.cfg]
2014-09-30 Bootloader can now quit without reset
    [main.c, startup_gcc.c]
2014-09-30 Added schematic for MPU9150 device
    [daughterboard.sch]
2014-10-20 Added MPU9150 footprint
2014-10-20 Added RTC footprint
2014-10-20 Added TMP100 footprint
2014-10-20 Added DRV8830 footprint
2014-10-20 Added temp sensor datasheet
2014-10-20 Added SD card footprint
2014-10-20 Added audio codec footprint
2014-10-20 Added pin 1 market to audio codec
2014-10-20 Added dac footprint
2014-10-21 Added the LCD footprint
2014-10-21 Added mainboard KiCad files, DRV8830, MPU-9150, and TMP100
    [mainboard.sch]
2014-10-21 Added push sdcard footprint
2014-10-21 Added push sdcard socket datasheet
2014-10-21 Committing in-progress work on redoing the CC3200 symbol
    [cc3200board.sch]
2014-10-22 Added launchpad footprint
2014-10-22 Fixed gitignore line to ignore temp KiCad files
2014-10-22 Added TivaLaunchpad part
    [mainboard.sch]
2014-10-22 Added peripherals schematic with TMP100 reference design
    [mainboard.sch, peripherals.sch]
2014-10-22 Exported MadParts to KiCad library
2014-10-23 Added KiCad autosaves to gitignore
2014-10-23 Added schematic for RTC
    [mainboard.sch, peripherals.sch]
2014-10-23 Added The motor driver circuits
    [peripherals.sch]
2014-10-23 Fixed motor controller 2 connecting to motor 1 nets
    [peripherals.sch]
2014-10-23 Removed unnecessary no-connects
    [peripherals.sch]
2014-10-23 Renamed peripherals schematic to i2c_peripherals
    [i2c_peripherals.sch, mainboard.sch]
2014-10-23 Added MPU schematic
    [i2c_peripherals.sch]
2014-10-23 Fixed reference to i2c peripherals in mainboard
    [i2c_peripherals.sch, mainboard.sch]
2014-10-23 Added SPI peripherals and SD Card schematic
    [SPI_peripherals.sch]
2014-10-23 Added datasheet for SPI flash part
    [cc3200board.sch]
2014-10-31 Finalized power/RF subsystems for CC3200board
    [cc3200board.sch]
2014-10-31 Added initial GPIO/JTAG/SOP breakout pins. Impedance controlled traces labelled.
    [cc3200board-io.sch, cc3200board.sch]
2014-10-31 Fixed VQFN64 footprint
2014-11-01 Added schematic for DAC
    [SPI_peripherals.sch, i2c_peripherals.sch, mainboard.sch]
2014-11-01 Added ~RST net
    [mainboard.sch]
2014-11-02 Added footprints for all CC3200 components
    [cc3200board.sch]
2014-11-02 Added MCP footprint
2014-11-11 Changed pull-down on SD card to 10k
    [SPI_peripherals.sch, i2c_peripherals.sch, mainboard.sch]
2014-11-11 Fixed which RST feeds the inverter, might be able to remove it
    [mainboard.sch]
2014-11-11 Added GLCD to schematic
    [SPI_peripherals.sch]
2014-11-11 Removed RST inverter
    [mainboard.sch]
2014-11-15 Swapped DAC to one in mainboard library
    [SPI_peripherals.sch, i2c_peripherals.sch, mainboard.sch]
2014-11-16 Added sensor array, with schematic, datasheet, and QRE11131GR part
    [sensorarray.sch]
2014-11-17 Removed temperature sensor
    [i2c_peripherals.sch]
2014-11-17 Added Audio codec and launchpad connection schematics
    [AudioCodec.sch, LaunchpadConnection.sch, mainboard.sch]
2014-11-17 Added footprint for QRE1113
2014-11-18 Added simple peripherals to launchpad schematic
    [LaunchpadConnection.sch]
2014-11-18 Added SPI CS decoder
    [SPI_peripherals.sch]
2014-11-18 First version of the PCB layout of the sensor array
    [.kicad_pcb.kicad_pcb, sensorarray.kicad_pcb, sensorarray.sch]
2014-11-18 Swapped the diode OR gate on the 3-8 to pulldowns
    [AudioCodec.sch, LaunchpadConnection.sch, SPI_peripherals.sch, i2c_peripherals.sch, mainboard.sch]
2014-11-18 Committing final changes
    [cc3200board-io.sch, cc3200board.sch]
2014-11-18 Added i2c exposed header
    [i2c_peripherals.sch]
2014-11-18 Buffered off the audio codec to let it share the spi bus
    [AudioCodec.sch]
2014-11-18 Added missing no-connect flags to line-out on codec
    [AudioCodec.sch]
2014-11-18 Named some default named connectors, fixed incorrect pull down
    [LaunchpadConnection.sch, SPI_peripherals.sch]
2014-11-18 Added mounting holes, removed dimensions
    [sensorarray.kicad_pcb, sensorarray.sch]
2014-11-18 Fixed crystals and added mic to audio codec
    [AudioCodec.sch, i2c_peripherals.sch]
2014-11-18 Added notation for mounting holes
    [sensorarray.sch]
2014-11-18 Added copper pour
    [sensorarray.kicad_pcb]
2014-11-18 Added SilkS labels for pins
    [sensorarray.kicad_pcb]
2014-11-18 Footprints update, planning update
2014-11-19 Added connector for Line Sensors, and fixed pots/photsensors
    [AudioCodec.sch, LaunchpadConnection.sch, SPI_peripherals.sch, i2c_peripherals.sch, mainboard.sch]
2014-11-23 Changed buffers to 3v3 compatible version
    [AudioCodec.sch]
2014-11-23 Added CC3200 bus cutoff schematics
    [BusSplitter.sch, LaunchpadConnection.sch, mainboard.sch]
2014-11-23 Added I2C transceiver
    [BusSplitter.sch]
2014-11-23 Added i2c transceiver datasheet
2014-11-23 Added i2c transciever footprint
2014-11-23 Added header containing all interrupt pins
    [LaunchpadConnection.sch]
2014-11-23 Doubled the power pins, and added interrupt out to bb interface
2014-11-23 Replaced cc3200 bus isolation with jumpers
    [BusSplitter.sch]
2014-11-23 Added daughterboard footprint
2014-11-23 Added Board to Board part to mainboard.lib
2014-11-23 Fixed incorrect part description for I2C Transceiver
2014-11-23 Updated board-to-board interface definition with CC3200 GPIO lines
    [cc3200board.sch]
2014-11-23 Connected GLCD_A0 to Launchpad and buffered it
    [BusSplitter.sch, LaunchpadConnection.sch]
2014-11-23 Added connections to Wifi Board
    [WifiConnections.sch, mainboard.sch]
2014-11-23 Added header for remaining GPIOs on Launchpad
    [LaunchpadConnection.sch]
2014-11-23 Fixed silk on pads in pcb layout
    [sensorarray.kicad_pcb]
2014-11-23 Fixed CC3200 symbol, missing GPIO28 pin. Complete pin check on symbol
    [cc3200board-io.sch]
2014-11-23 Fixing SPI bugs, adding SPI port
    [SPI_peripherals.sch]
2014-11-24 Cleaning up some SPI connections, nothing functional
    [SPI_peripherals.sch]
2014-11-24 Added missing pullups on the RTC interrupt lines
    [i2c_peripherals.sch]
2014-11-24 Split the motors into two separate headers
    [i2c_peripherals.sch]
2014-11-24 Added a jumper to the backlight on the GLCD
    [SPI_peripherals.sch]
2014-11-24 Added coupling capacitors to DAC
    [SPI_peripherals.sch]
2014-11-24 Added decoupling caps to the codec
    [AudioCodec.sch]
2014-11-24 Added reference schematic for codec
2014-11-24 Finished schematic layout
    [cc3200board-io.sch, cc3200board.sch]
2014-11-24 added 50k pullup to CS1 again, since we can leave it unpopulated
    [SPI_peripherals.sch]
2014-11-24 Added headphone jack for codec
    [AudioCodec.sch]
2014-11-24 Added footprint for headphone jack
2014-11-24 Added net names, fixed misnamed GLCD_A0
    [AudioCodec.sch, BusSplitter.sch, LaunchpadConnection.sch, SPI_peripherals.sch, WifiConnections.sch, i2c_peripherals.sch]
2014-11-24 Fixed double use of SPI_CS4
    [SPI_peripherals.sch]
2014-11-24 Added power converter datasheet
2014-11-24 Added power regulator
    [Power.sch, mainboard.sch]
2014-11-24 Added power regulator footprint
2014-11-24 Fixed mirrored footprint, outlines
    [cc3200board-io.sch, cc3200board.sch]
2014-11-24 Moved MPU silkscreen off of the pads
2014-11-24 Improved pad placement and labelling for PowerPad chips
2014-11-24 Fixed SDCARD silkscreen overlapping pins
2014-11-24 fix merge conflict in footprints
2014-11-24 Fixed some silkscreen stuff
2014-11-24 Added net name for swapped header row
    [SPI_peripherals.sch]
2014-11-24 Exported footprints
2014-11-24 Added footprint for 32.768KHz xtal
2014-11-24 Annotations, DRC fixing, and first round of footprint matching
    [Power.sch, SPI_peripherals.sch, WifiConnections.sch, i2c_peripherals.sch]
2014-11-24 Added HC-49US footprint
2014-11-24 Exported crystal footprint
2014-11-25 Added some standard header footprints
2014-11-25 Added inductor footprints for the 1008 and 0402 packages
2014-11-25 Added Mic footprint
2014-11-25 Fixed flipped pin direction on mic footprint
2014-11-25 Added pushbutton footprint
2014-11-25 Increased hole and pad size for headers
2014-11-25 Added footprint for Potentiometer
2014-11-25 Added Audio coded net to optional peripherals header
    [LaunchpadConnection.sch]
2014-11-25 Exporting footprints
2014-11-25 Exported netlist and matched footprints
2014-11-25 Preliminary PCB layout, not much
    [mainboard.kicad_pcb]
2014-11-25 Added CAP footprint for 330uF
2014-11-25 Finished first draft of rev 1 board
    [AudioCodec.sch, BusSplitter.sch, LaunchpadConnection.sch, Power.sch, SPI_peripherals.sch, WifiConnections.sch, i2c_peripherals.sch, mainboard.kicad_pcb]
2014-11-27 Rev1.1 layout, without passives
    [mainboard.kicad_pcb]
2014-11-28 Temporary reorg commit
    [cc3200board.kicad_pcb]
2014-11-28 SPI and I2C busses nearly finished, Most traces in place, except for the longest ones
    [mainboard.kicad_pcb]
2014-11-28 Added footprint for IrDA module
2014-11-29 All but Spi_CS and power are routed.
    [mainboard.kicad_pcb]
2014-11-29 Routed PA and DIG power planes
    [cc3200board.kicad_pcb]
2014-11-29 Added Vishay IrDA module footprint
2014-11-29 Completed power reroute, PCB plane cleanup. Two DRC violations on DCDC_DIG and DCDC_ANA intersection left.
    [cc3200board.kicad_pcb]
2014-11-30 All finished but the power and GND
    [mainboard.kicad_pcb]
2014-11-30 Finished major layout, RF vias and final ground pins left
    [cc3200board.kicad_pcb]
2014-12-01 Rev 1.0 of CC3200board
    [cc3200board-io.sch, cc3200board.kicad_pcb, cc3200board.sch]
2014-12-01 Fixed error in GND plane on L4
    [cc3200board-io.sch, cc3200board.kicad_pcb, cc3200board.sch]
2014-12-01 Finished Rev1.1, everything is connected, but not double checked yet
    [mainboard.kicad_pcb]
2014-12-01 Removed traces from holes
    [mainboard.kicad_pcb]
2014-12-02 Cleaning up busses
    [mainboard.kicad_pcb]
2014-12-02 Final cleanups, ready for silk
    [mainboard.kicad_pcb]
2014-12-02 Changed thermal relief of the zones to solid
    [mainboard.kicad_pcb]
2014-12-02 Updated RTC footprint to move the pin 1 marker inside the part
2014-12-02 Added Silk for SPI and I2C bus
    [mainboard.kicad_pcb]
2014-12-02 removed dimensions from edge layer
    [mainboard.kicad_pcb]
2014-12-02 Fixed busses to be same width
    [mainboard.kicad_pcb]
2014-12-02 Fixed bug with an unconnected net
    [mainboard.kicad_pcb]
2014-12-02 Added Penguin Skywalker
    [mainboard.kicad_pcb]
2014-12-02 Added bin folder to gitignore, generating gerbers there
2014-12-02 Revision 1.1 commit. Version submitted to OSH
    [cc3200board.kicad_pcb]
2015-01-25 Fixed layout issues with mainboard v1.1
    * Increased width of power traces
    * Increased number of traces connecting power and ground planes
    * Cleaned up some routing
    * Reduced via size
    [mainboard.kicad_pcb]
2015-01-26 Removed audio codec from layout.
    [BusSplitter.sch, WifiConnections.sch, mainboard.kicad_pcb, mainboard.sch]
2015-02-12 Added footprint for CPLD
2015-02-13 Replaced buffers with CPLD
    [BusSplitter.sch, SPI_peripherals.sch]
2015-02-13 Added CPLD footprint to mod file
2015-02-13 Various fixes to schematics and footprints:
    * Added pullup resistors to bumpers
    * Changed value of RLED resistor
    * Added resistor to GLED
    * Changed SPI pullup resistors to 47k
    * Added JTAG header for CPLD
    * Changed motor driver footprint to MSOP
    [BusSplitter.sch, LaunchpadConnection.sch, Power.sch, SPI_peripherals.sch, WifiConnections.sch]
2015-02-17 Added power LED, removed Codec Peripheral pin
    [BusSplitter.sch, LaunchpadConnection.sch, Power.sch, SPI_peripherals.sch, WifiConnections.sch, i2c_peripherals.sch]
2015-02-26 Various changes
    * Began Rev2 Layout
    * Added Pullup Resistors to LP I2C
    * Added IrDA Module
    [BusSplitter.sch, LaunchpadConnection.sch, Power.sch, SPI_peripherals.sch, WifiConnections.sch, i2c_peripherals.sch, mainboard.kicad_pcb, mainboard.sch]
2015-02-28 Added LM4808 audio output to headphones
    [Audio.sch, mainboard.sch]
2015-02-28 First revision of mic and MAX9814, not finished
    [Audio.sch, mainboard.sch]
2015-02-28 Fixed Switch footprint
2015-02-28 Further work on the rev2 layout
    [BusSplitter.sch, LaunchpadConnection.sch, mainboard.kicad_pcb]
2015-02-28 Added 1.8v regulator datasheet
2015-03-01 Finished draft 1 of Rev 2 layout
    [Audio.sch, BusSplitter.sch, LaunchpadConnection.sch, Power.sch, SPI_peripherals.sch, WifiConnections.sch, i2c_peripherals.sch, mainboard.kicad_pcb]
2015-03-01 Started work on CC3200MOD board
    [cc3200board.kicad_pcb, cc3200modboard.sch]
2015-03-01 Finalized schematic for CC3200MOD board
    1. Added new power and activity LEDs.
    2. Moved UART from GPIO10/11 to GPIO1/2, freeing up two pins.
    3. GPIO31 no longer available.
    [cc3200modboard.sch]
2015-03-01 Apparently I forgot to save the most recent changes
    [mainboard.kicad_pcb]
2015-03-02 Full rework of all the silk screen, including bus labels, header labels, chip labels
    [mainboard.kicad_pcb]
2015-03-02 Condensed IrDA silk, changed A/B to L/R for Audio in
    [mainboard.kicad_pcb]
2015-03-02 Fixed reversed IrDA module instructions
    [mainboard.kicad_pcb]
2015-03-02 fixed DRC errors on schematic
    [Audio.sch, BusSplitter.sch, LaunchpadConnection.sch, Power.sch, SPI_peripherals.sch, WifiConnections.sch, i2c_peripherals.sch, mainboard.kicad_pcb]
2015-03-02 Finalized routing for cc3200mod board
    [cc3200modboard.kicad_pcb, cc3200modboard.sch]
2015-03-02 Moved a trace farther from the edge
    [mainboard.kicad_pcb]
2015-03-03 Added gerber outputs for rev2
    [mainboard-B_Cu.gbl, mainboard-B_Mask.gbs, mainboard-B_SilkS.gbo, mainboard-Edge_Cuts.gbr, mainboard-F_Cu.gtl, mainboard-F_Mask.gts, mainboard-F_SilkS.gto, mainboard.drl]
2015-03-03 Final version of rev 2
    [Audio.sch, BusSplitter.sch, LaunchpadConnection.sch, Power.sch, SPI_peripherals.sch, WifiConnections.sch, i2c_peripherals.sch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]
2015-03-05 Added 2x10 header to footprint file again
2015-03-06 Added lcd board
    [lcdboard.kicad_pcb, lcdboard.sch]
2015-03-09 Added mounting holes for lcdboard, and fab outputs
    [lcdboard.sch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]
2015-03-09 Committed version of CC3200 PCB for r2
    [cc3200modboard.kicad_pcb]
2015-03-09 Cleanup of project folder
    [daughterboard.sch]
2015-03-09 Merging in cc3200modboard
    [cc3200board.kicad_pcb, cc3200modboard.kicad_pcb, cc3200modboard.sch, daughterboard.sch]
2015-03-12 CC3200MOD footprint fix
2015-03-15 Finished revision 2 of WiFi Board
    [cc3200modboard.kicad_pcb, cc3200modboard.sch]
